adrianoncioiu/Brat-robotic-pentru-desen-caricatural-Licenta-2023/CAD/Pen/Screenshot (135).png

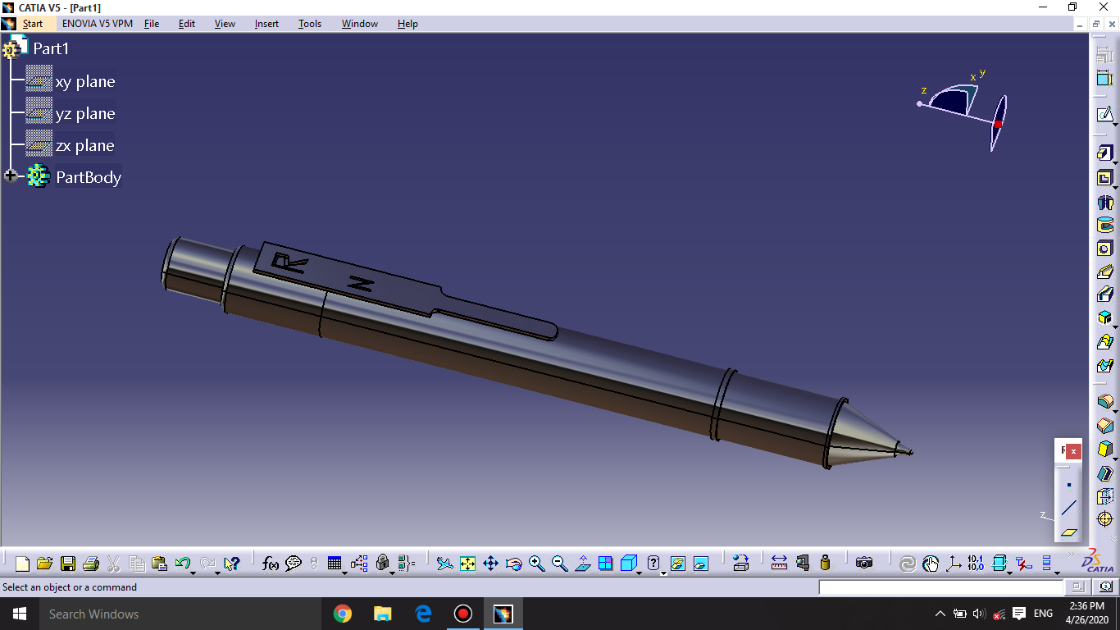
CAD/Pen/Screenshot (135).png
