adrianoncioiu/Brat-robotic-pentru-desen-caricatural-Licenta-2023/img/nou/blabla4.jpeg

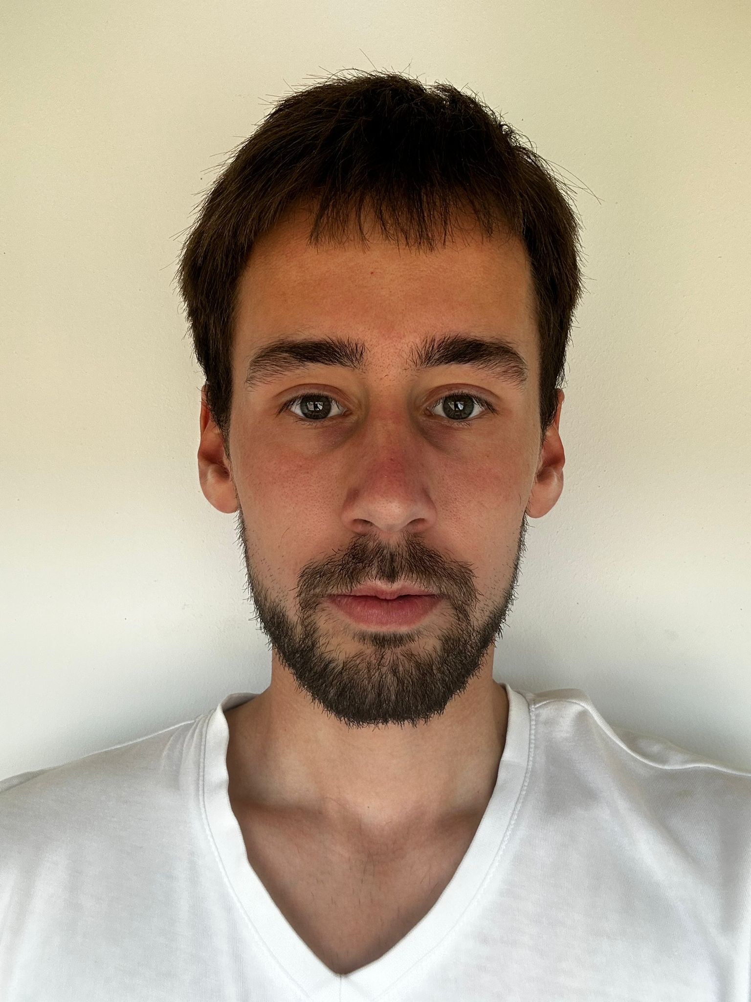
img/nou/blabla4.jpeg
