adrianoncioiu/Brat-robotic-pentru-desen-caricatural-Licenta-2023/img/nou/poza_blur.jpg

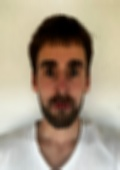
img/nou/poza_blur.jpg
