adrianoncioiu/Brat-robotic-pentru-desen-caricatural-Licenta-2023/img/nou/WhatsApp Image 2023-06-06 at 15.45.43.jpeg

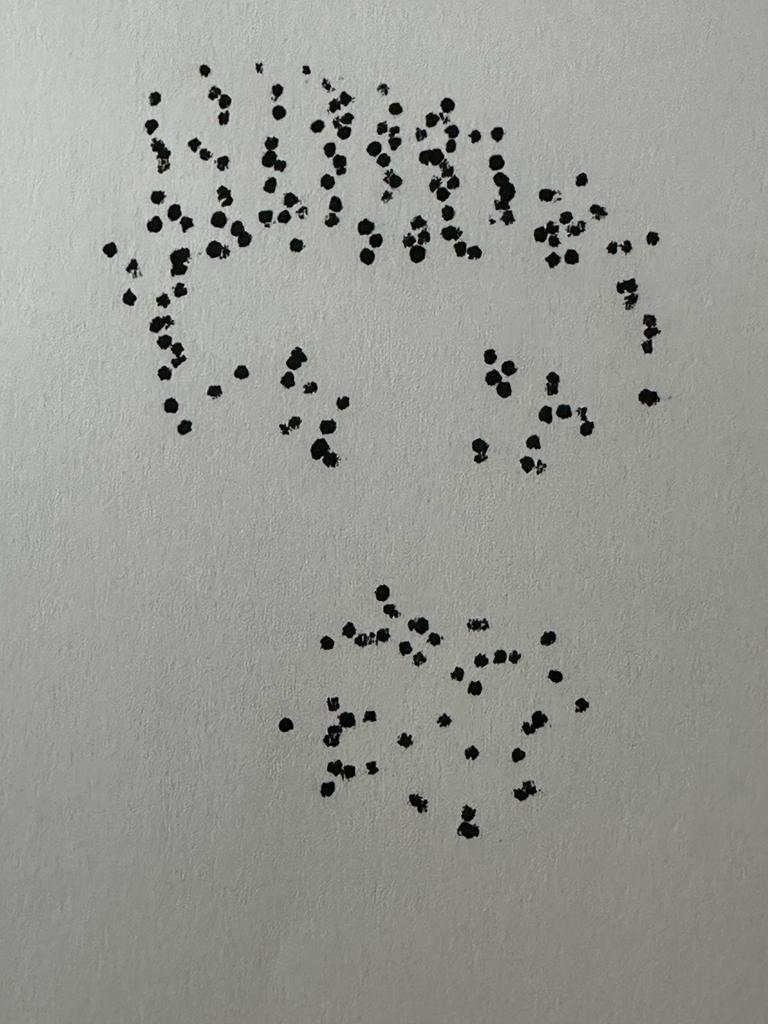
img/nou/WhatsApp Image 2023-06-06 at 15.45.43.jpeg
