adrianoncioiu/Brat-robotic-pentru-desen-caricatural-Licenta-2023/img/raspberry-pi-4-modell-b-4gb-sdram.jpg

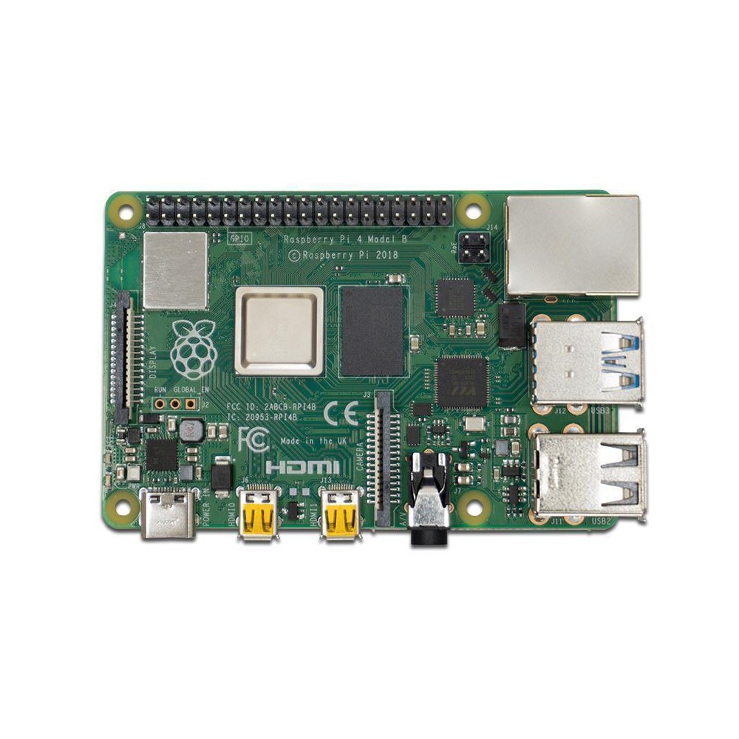
img/raspberry-pi-4-modell-b-4gb-sdram.jpg
