adrianoncioiu/Brat-robotic-pentru-desen-caricatural-Licenta-2023/img/raspberrypi_arduino_uno_serial_usb.png

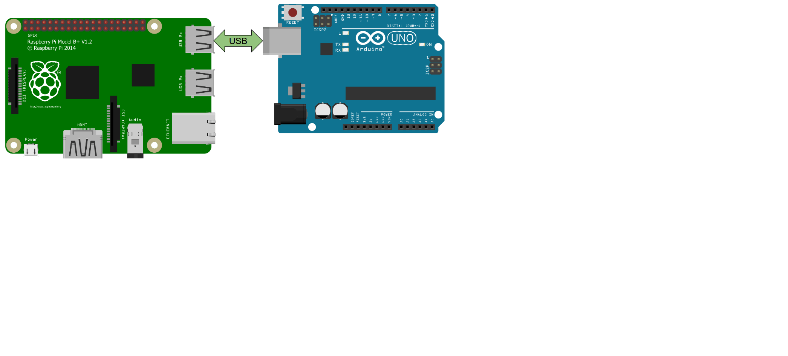
img/raspberrypi_arduino_uno_serial_usb.png
