adrianoncioiu/Brat-robotic-pentru-desen-caricatural-Licenta-2023/img/unnamed.jpg

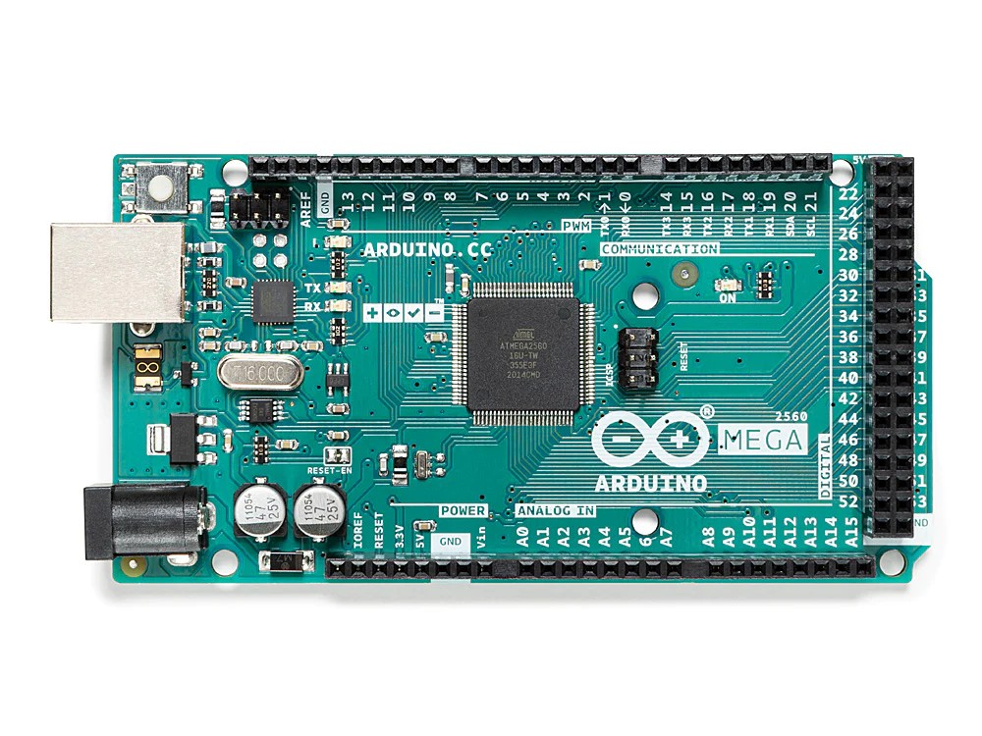
img/unnamed.jpg
