adrianoncioiu/Brat-robotic-pentru-desen-caricatural-Licenta-2023/img/WhatsApp Image 2023-06-01 at 18.26.57.jpeg

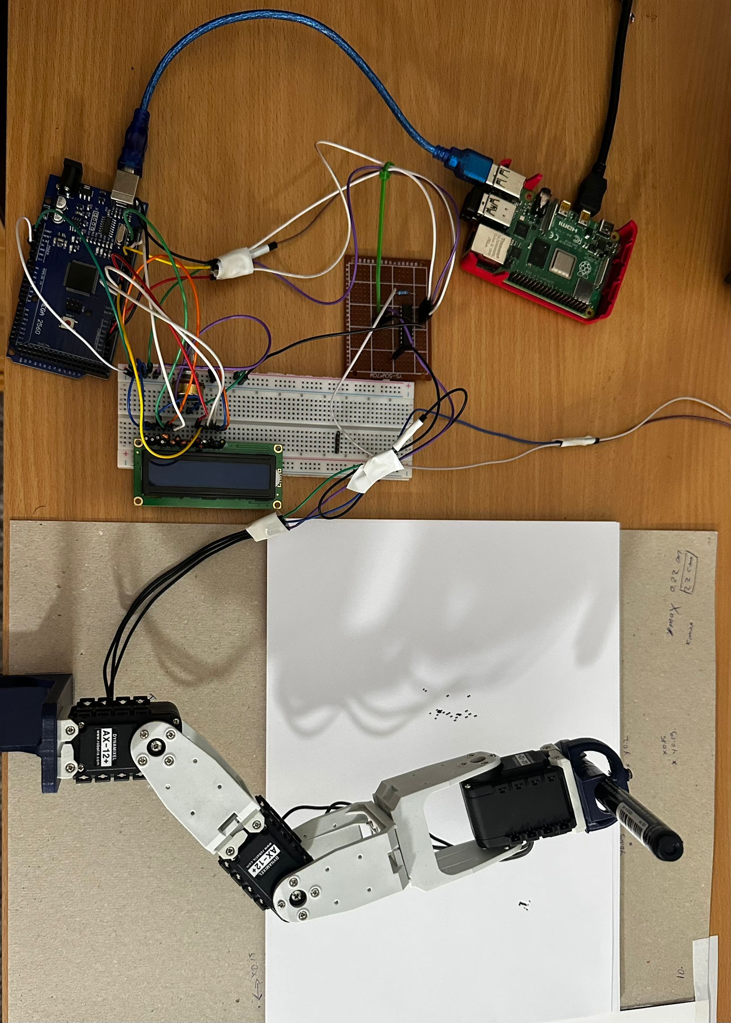
img/WhatsApp Image 2023-06-01 at 18.26.57.jpeg
