adrianoncioiu/Brat-robotic-pentru-desen-caricatural-Licenta-2023/procesare de img/blabla2.jpeg

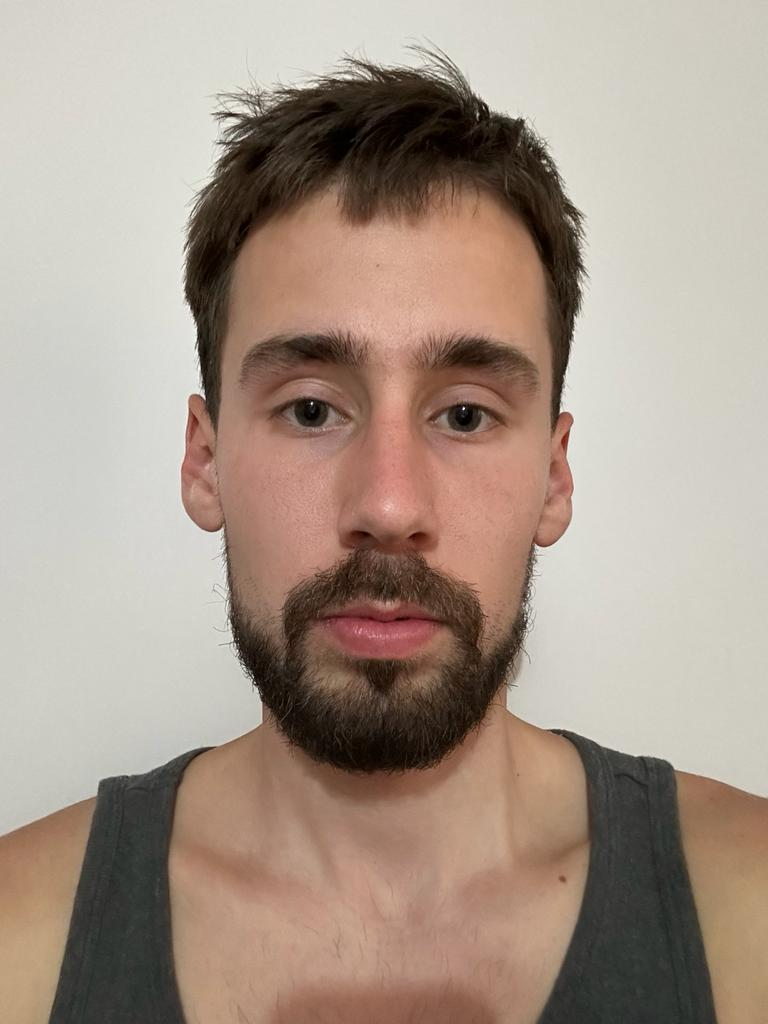
procesare de img/blabla2.jpeg
