adrianoncioiu/Brat-robotic-pentru-desen-caricatural-Licenta-2023/procesare de img/blabla3.jpeg

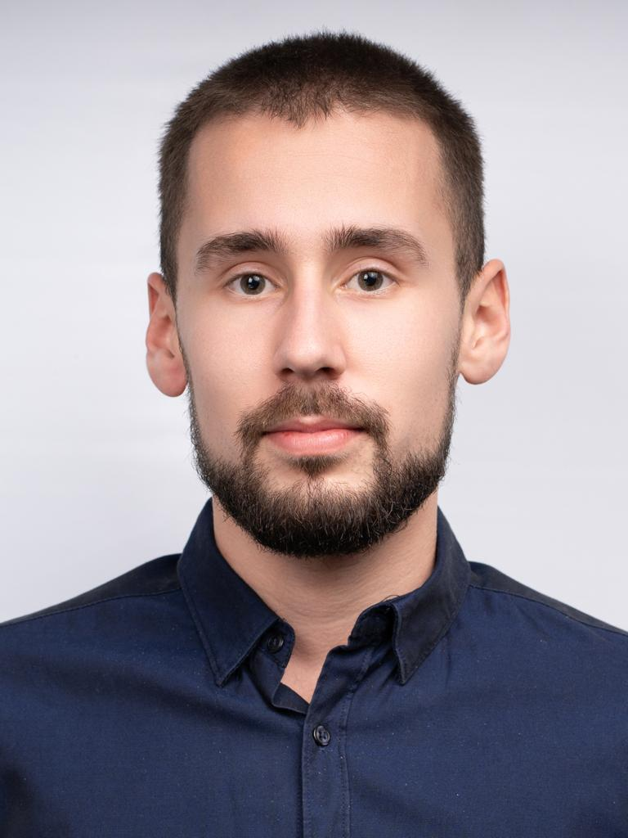
procesare de img/blabla3.jpeg
