adrianoncioiu/Brat-robotic-pentru-desen-caricatural-Licenta-2023/procesare de img/blabla.jpg

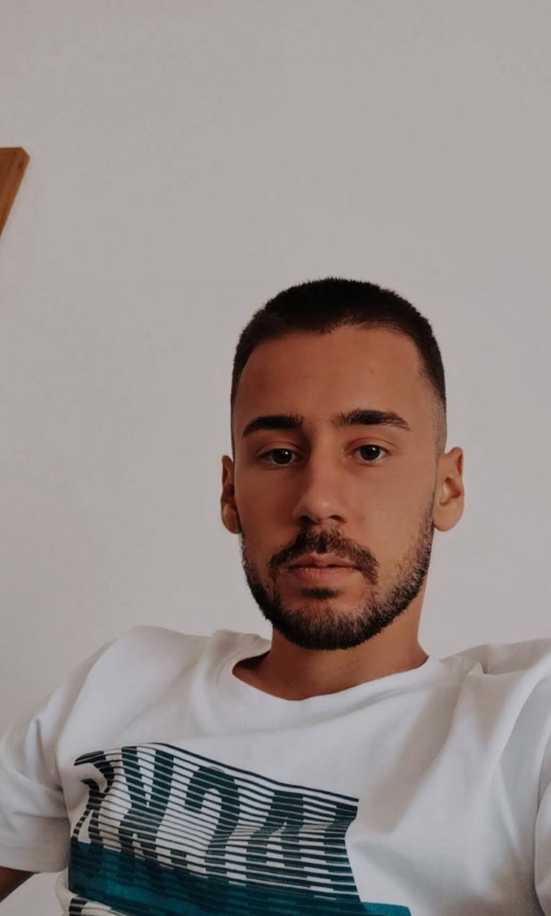
procesare de img/blabla.jpg
