adrianoncioiu/Brat-robotic-pentru-desen-caricatural-Licenta-2023/procesare de img/poza_dilatata.jpg

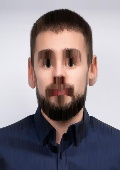
procesare de img/poza_dilatata.jpg
