adrianoncioiu/Brat-robotic-pentru-desen-caricatural-Licenta-2023/CAD/FP04-F4.igs

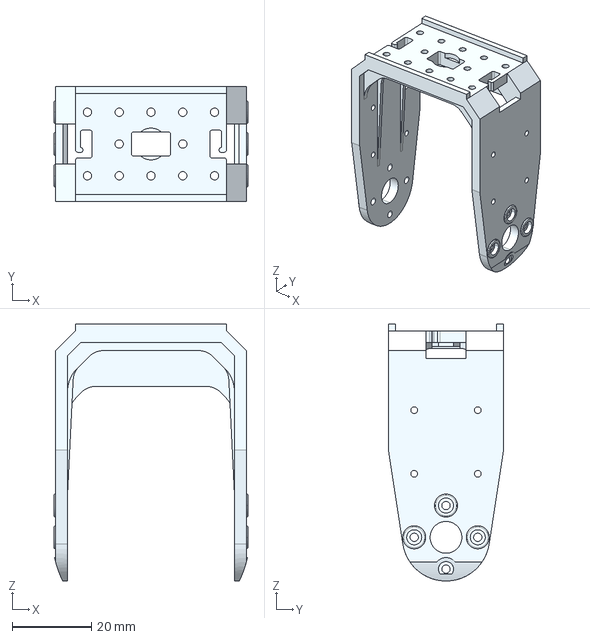
[picture p64: CAD file, 2023-04-28]
CAD/FP04-F4.igs
48.8 x 29.0 x 64.7 mm
