adrianoncioiu/Brat-robotic-pentru-desen-caricatural-Licenta-2023/de printat/Moneda.stl

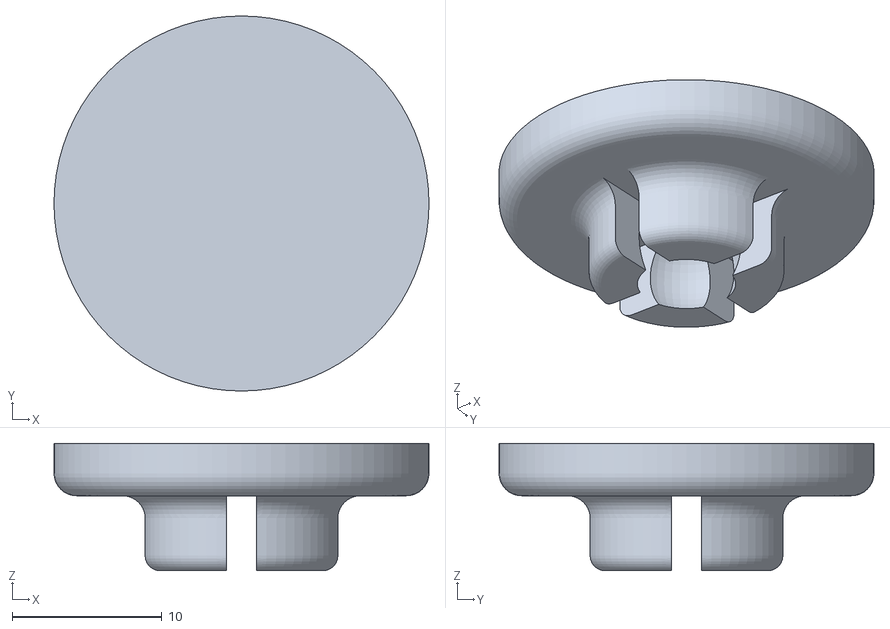
[picture p65: CAD file, 2023-03-07]
de printat/Moneda.stl
25.0 x 25.0 x 8.50
