adrianoncioiu/Brat-robotic-pentru-desen-caricatural-Licenta-2023/dynamixel-ax-12a.snapshot.2/AX-12A.stl

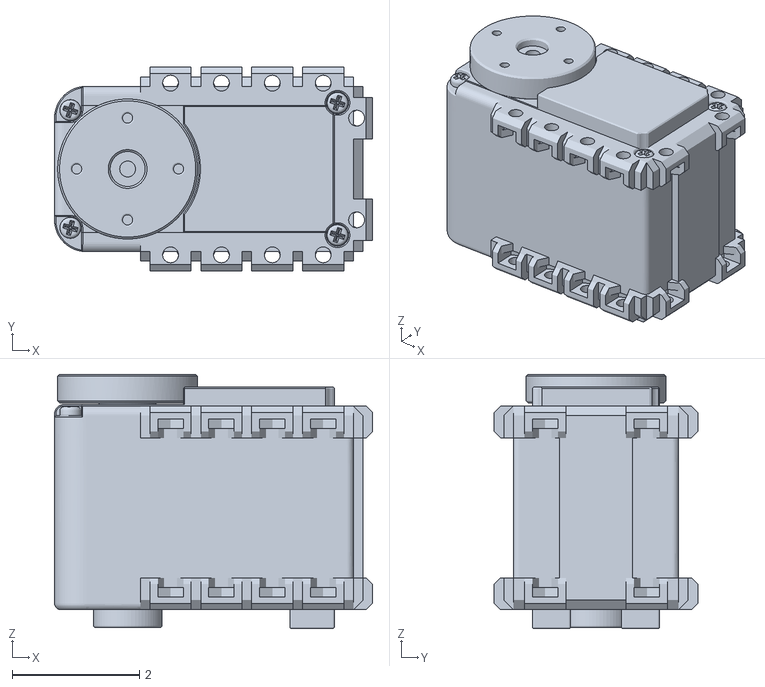
[picture p66: CAD file, 2023-03-07]
dynamixel-ax-12a.snapshot.2/AX-12A.stl
5.00 x 3.20 x 4.00
