adrianoncioiu/Brat-robotic-pentru-desen-caricatural-Licenta-2023/CAD/BPF-BU.stp

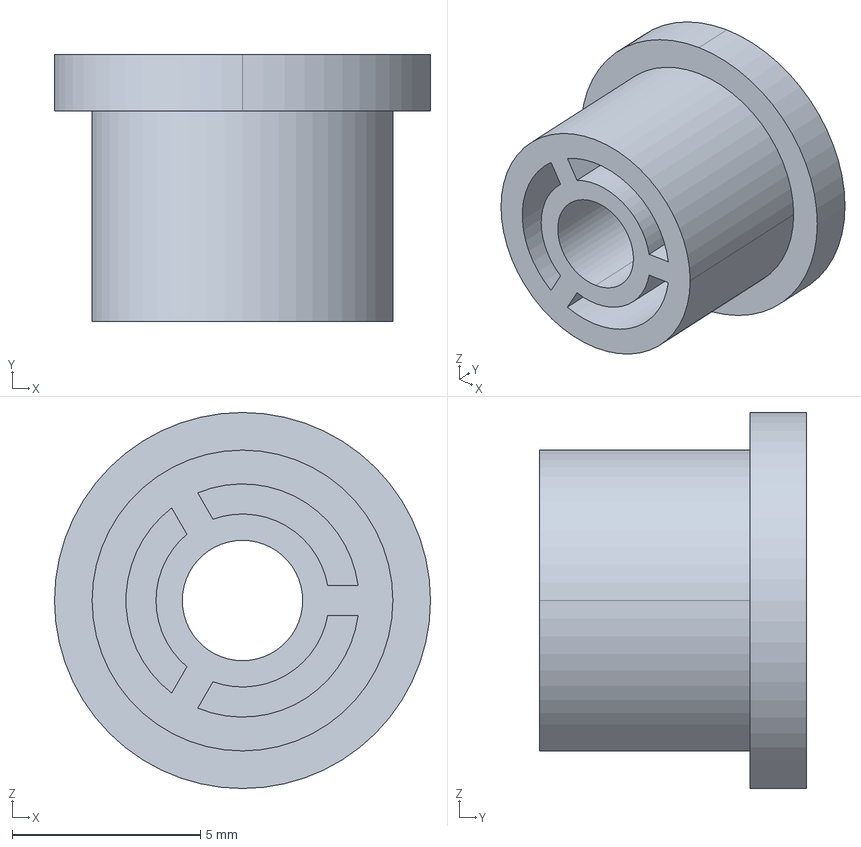
[picture p67: CAD file, 2023-04-28]
CAD/BPF-BU.stp
10.0 x 7.10 x 10.0 mm
