adrianoncioiu/Brat-robotic-pentru-desen-caricatural-Licenta-2023/de printat/Meghina.stl

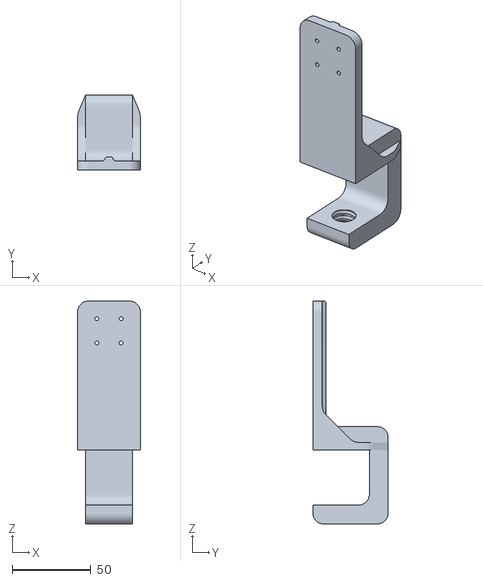
[picture p68: CAD file, 2023-03-07]
de printat/Meghina.stl
40.0 x 48.0 x 142.0
