adrianoncioiu/Brat-robotic-pentru-desen-caricatural-Licenta-2023/CAD/AX-12A.stp

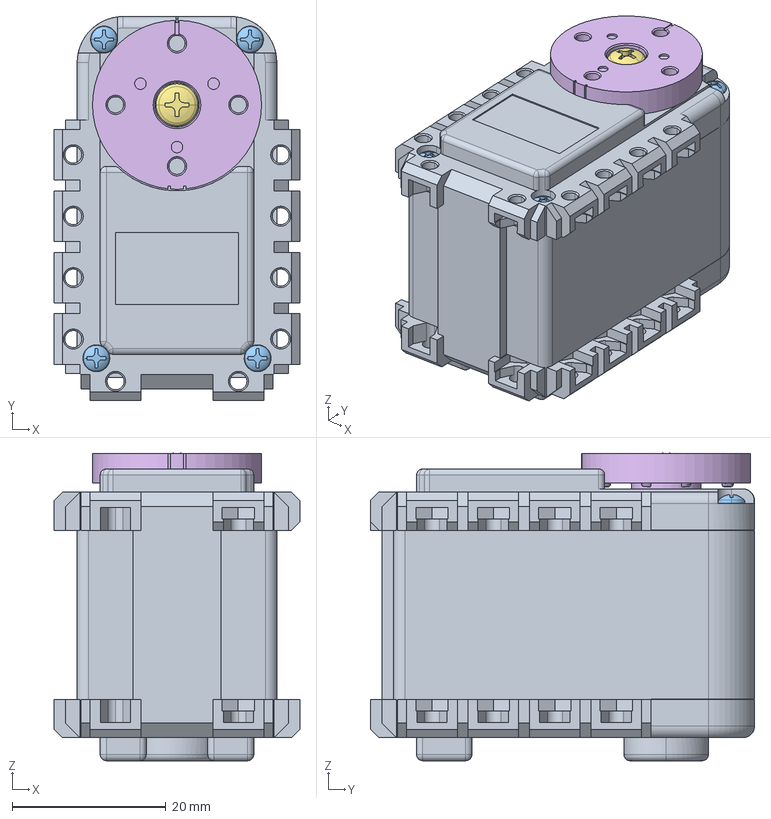
[picture p69: CAD file, 2023-03-07]
CAD/AX-12A.stp
32.0 x 50.0 x 40.0 mm
PRT0001
PRT0002
PRT0003 x 4
PRT0004 x 2
PRT0005
PRT0006
PRT0007
