adrianoncioiu/Brat-robotic-pentru-desen-caricatural-Licenta-2023/CAD/FP04-F2.stp

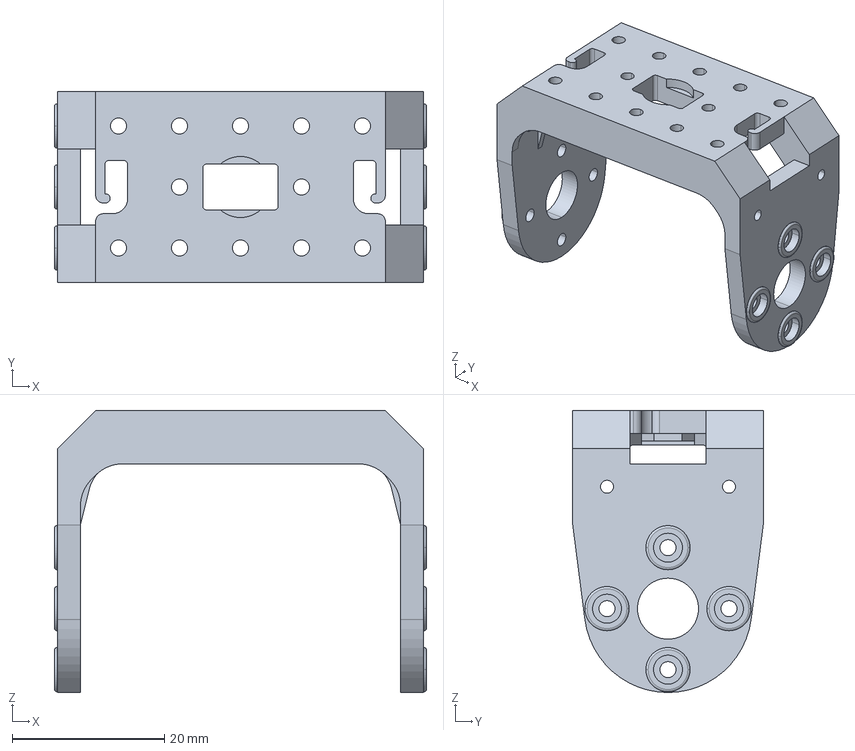
[picture p70: CAD file, 2023-03-07]
CAD/FP04-F2.stp
48.8 x 25.0 x 37.0 mm
