adrianoncioiu/Brat-robotic-pentru-desen-caricatural-Licenta-2023/CAD/FP04-F3.stp

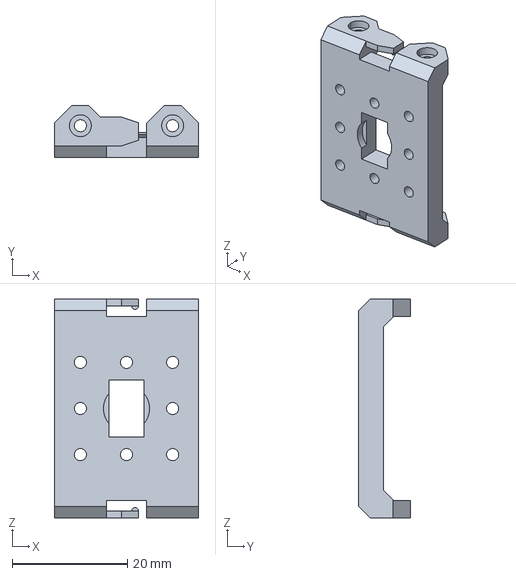
[picture p71: CAD file, 2023-03-07]
CAD/FP04-F3.stp
25.0 x 9.00 x 38.0 mm
