adrianoncioiu/Brat-robotic-pentru-desen-caricatural-Licenta-2023/(list of files, cad)

Other CAD files:
CAD/FP04-F4 (1).stp
CAD/0.0.CATPart
CAD/10179925.CATPart
CAD/10325612.CATPart
CAD/ASM0001_ASM.1.9.CATProduct
CAD/ASM0001_ASM.1.CATProduct
CAD/AX-12A.CATProduct
CAD/BPF-BU.CATPart
CAD/BPF-BU.dwg
CAD/BPF-BU.igs
CAD/FP04-F2.CATPart
CAD/FP04-F3.CATPart
CAD/FP04-F4.CATPart
CAD/FP04-F4.dwg
CAD/Masa.CATPart
CAD/PRT0001.5.13.CATPart
CAD/PRT0001.5.CATPart
CAD/PRT0001.CATPart
CAD/PRT0002.6.14.CATPart
CAD/PRT0002.6.CATPart
CAD/PRT0002.CATPart
CAD/PRT0003.7.15.CATPart
CAD/PRT0003.7.CATPart
CAD/PRT0003.CATPart
CAD/PRT0004.8.16.CATPart
CAD/PRT0004.8.CATPart
CAD/PRT0004.CATPart
CAD/PRT0005.2.10.CATPart
CAD/PRT0005.2.CATPart
CAD/PRT0005.CATPart
CAD/PRT0006.3.11.CATPart
CAD/PRT0006.3.CATPart
CAD/PRT0006.CATPart
CAD/PRT0007.4.12.CATPart
CAD/PRT0007.4.CATPart
CAD/PRT0007.CATPart
CAD/Pen/Pen.CATPart
CAD/ROBOT_3d.CATProduct
CAD/foaie.CATPart
