adrianoncioiu/Brat-robotic-pentru-desen-caricatural-Licenta-2023/CAD/BPF-BU.pdf

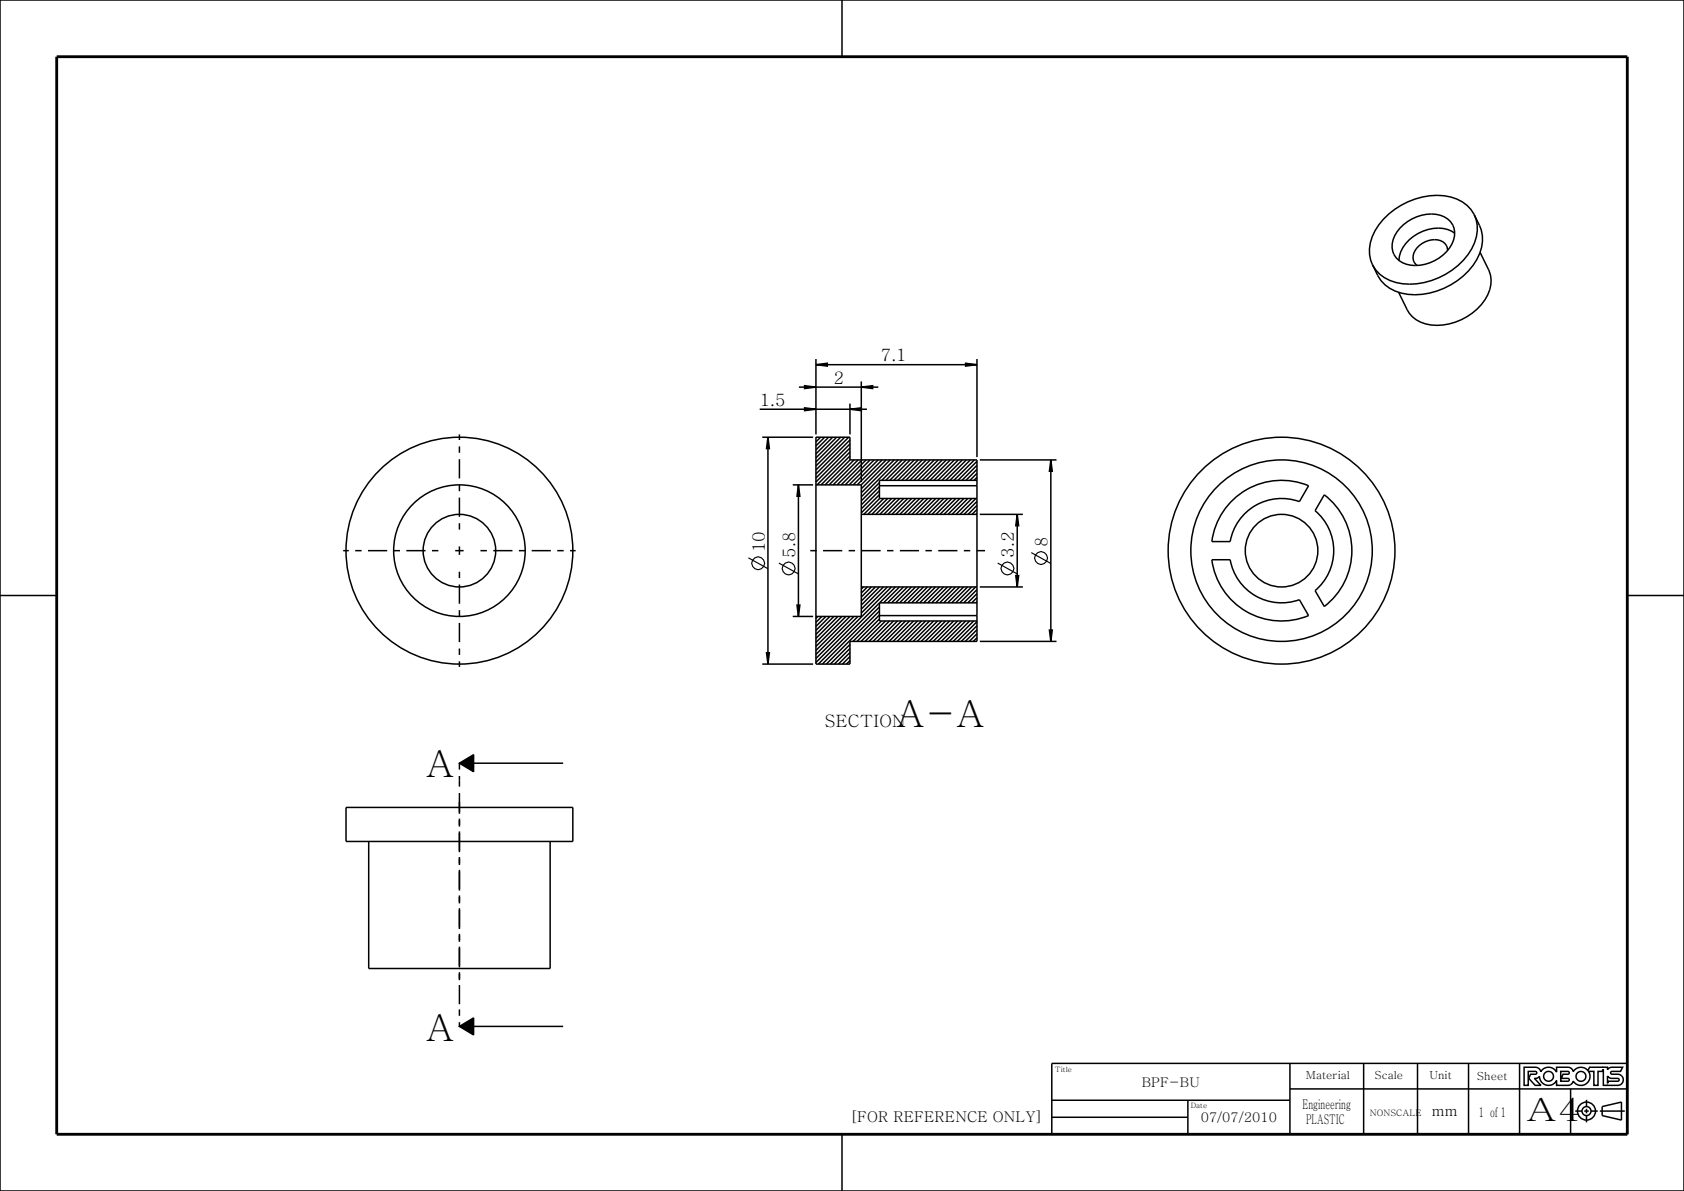
[picture p72: page 1]
NONSCALE; SECTION A-A

Title BPF-BU | Material | Scale | Unit | Sheet

[FOR REFERENCE ONLY]

PLASTIC | | mm | 1 of 1 Engineering
Date 07/07/2010
