adrianoncioiu/Brat-robotic-pentru-desen-caricatural-Licenta-2023/scheme circuit/schema2_bb.pdf

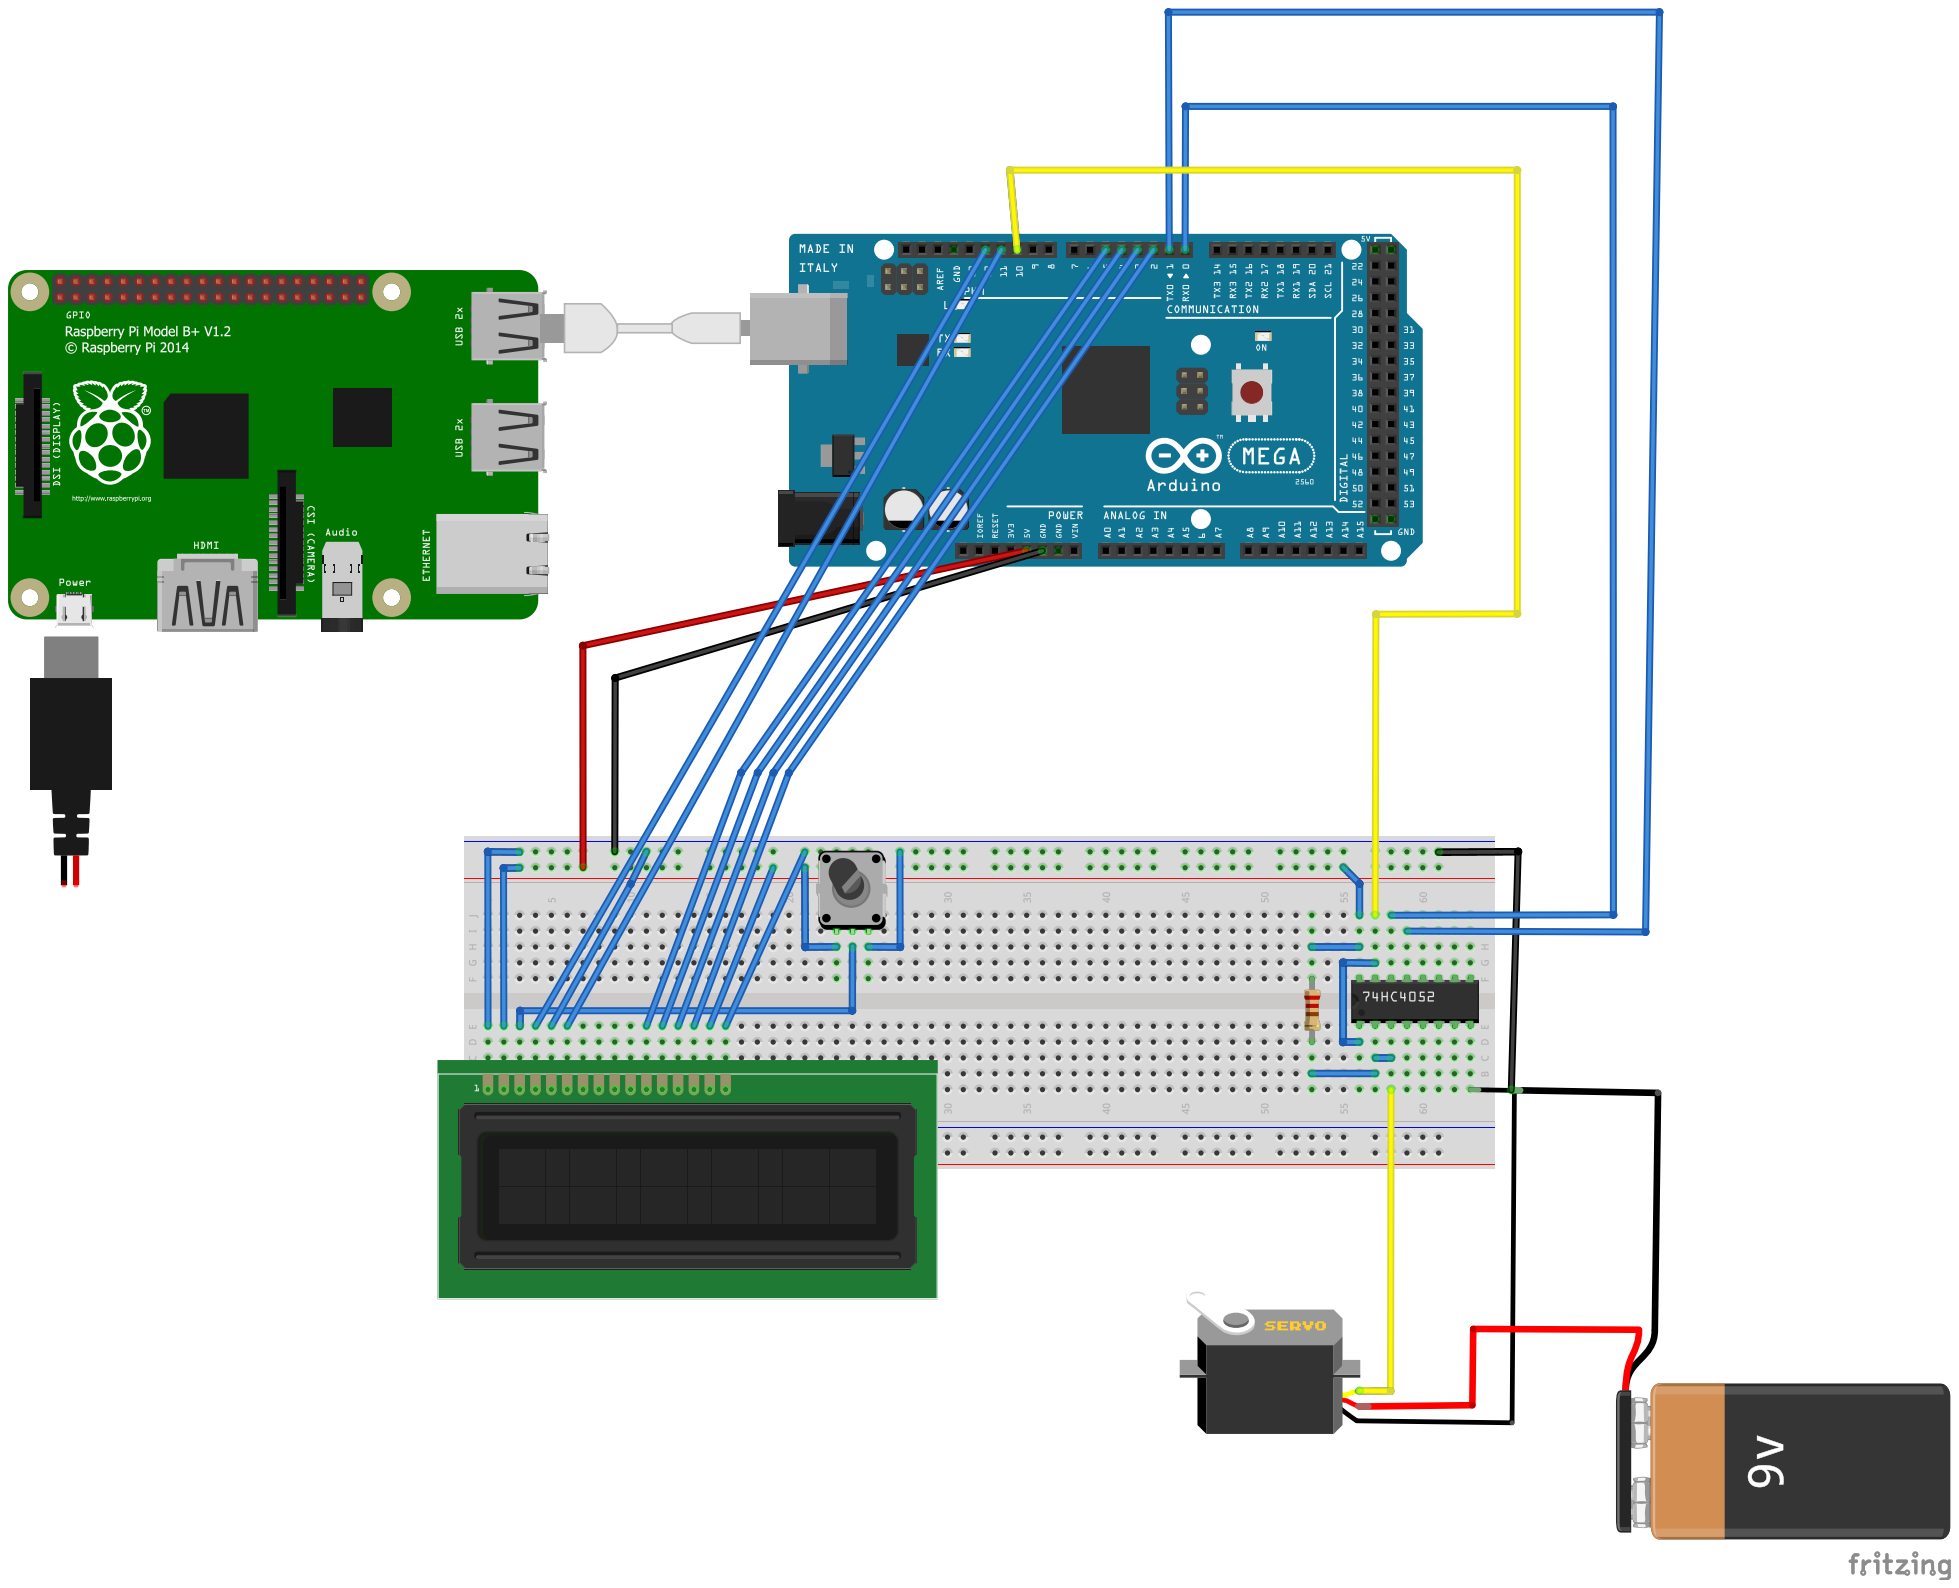
[picture p73: page 1]
