adrianoncioiu/Brat-robotic-pentru-desen-caricatural-Licenta-2023/scheme circuit/schema2_schem.pdf

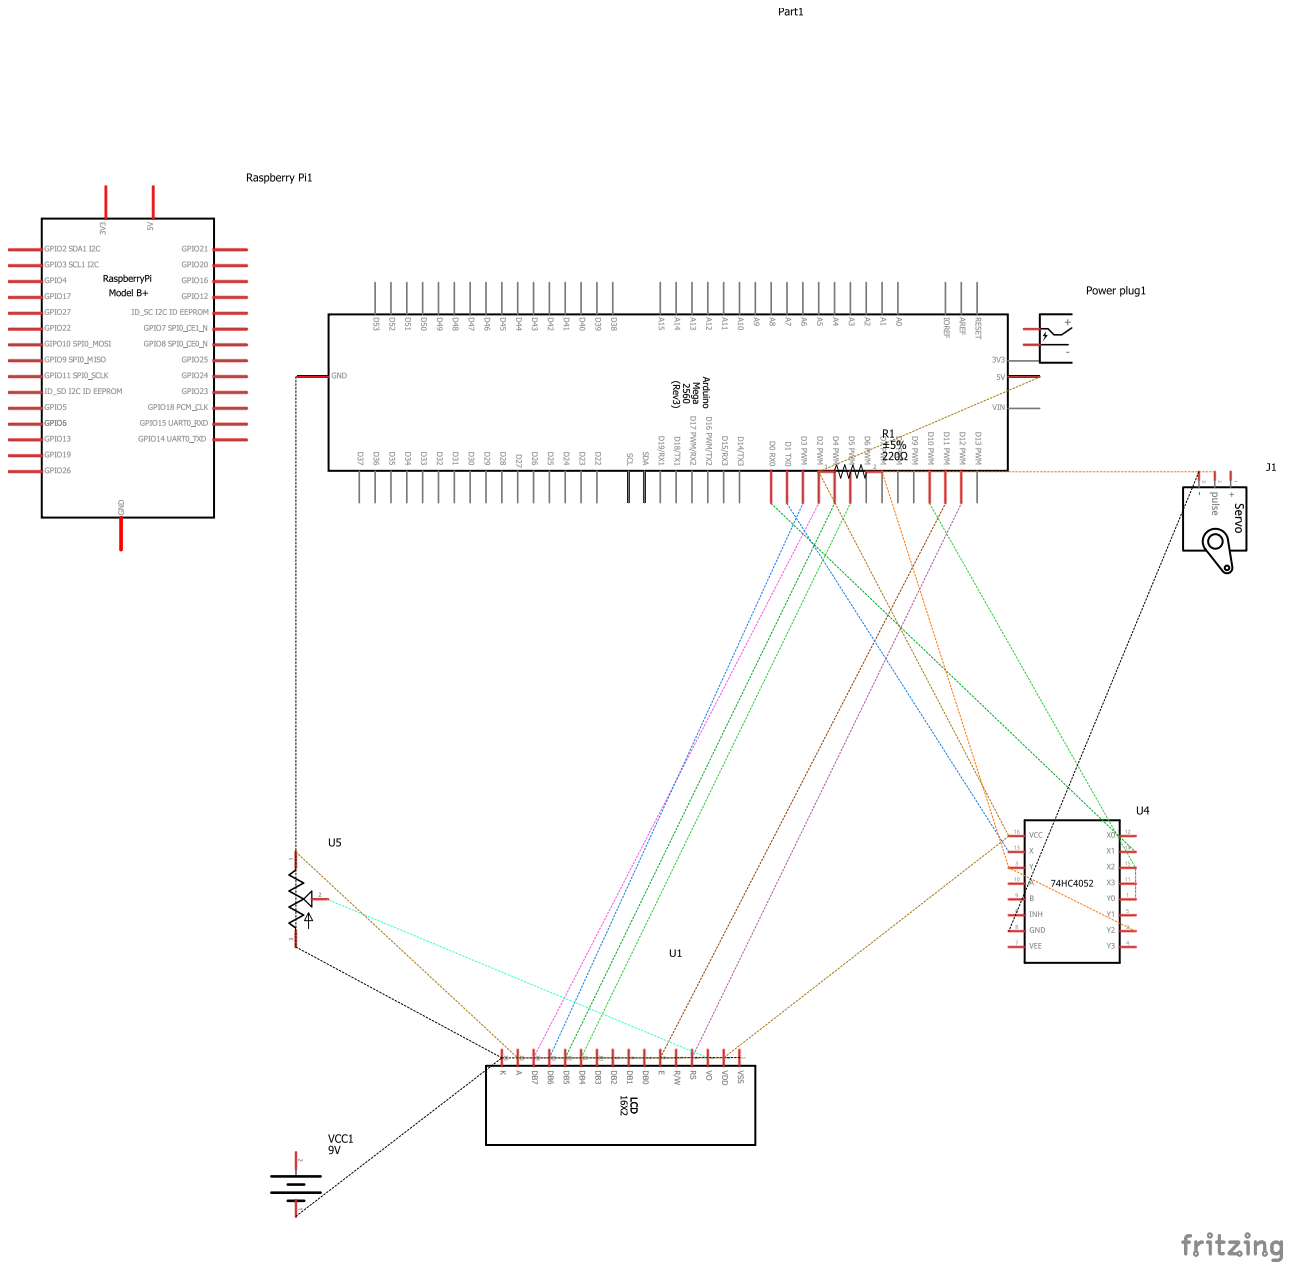
[picture p74: page 1]
