adrianoncioiu/Brat-robotic-pentru-desen-caricatural-Licenta-2023/scheme circuit/schema3_bb.pdf

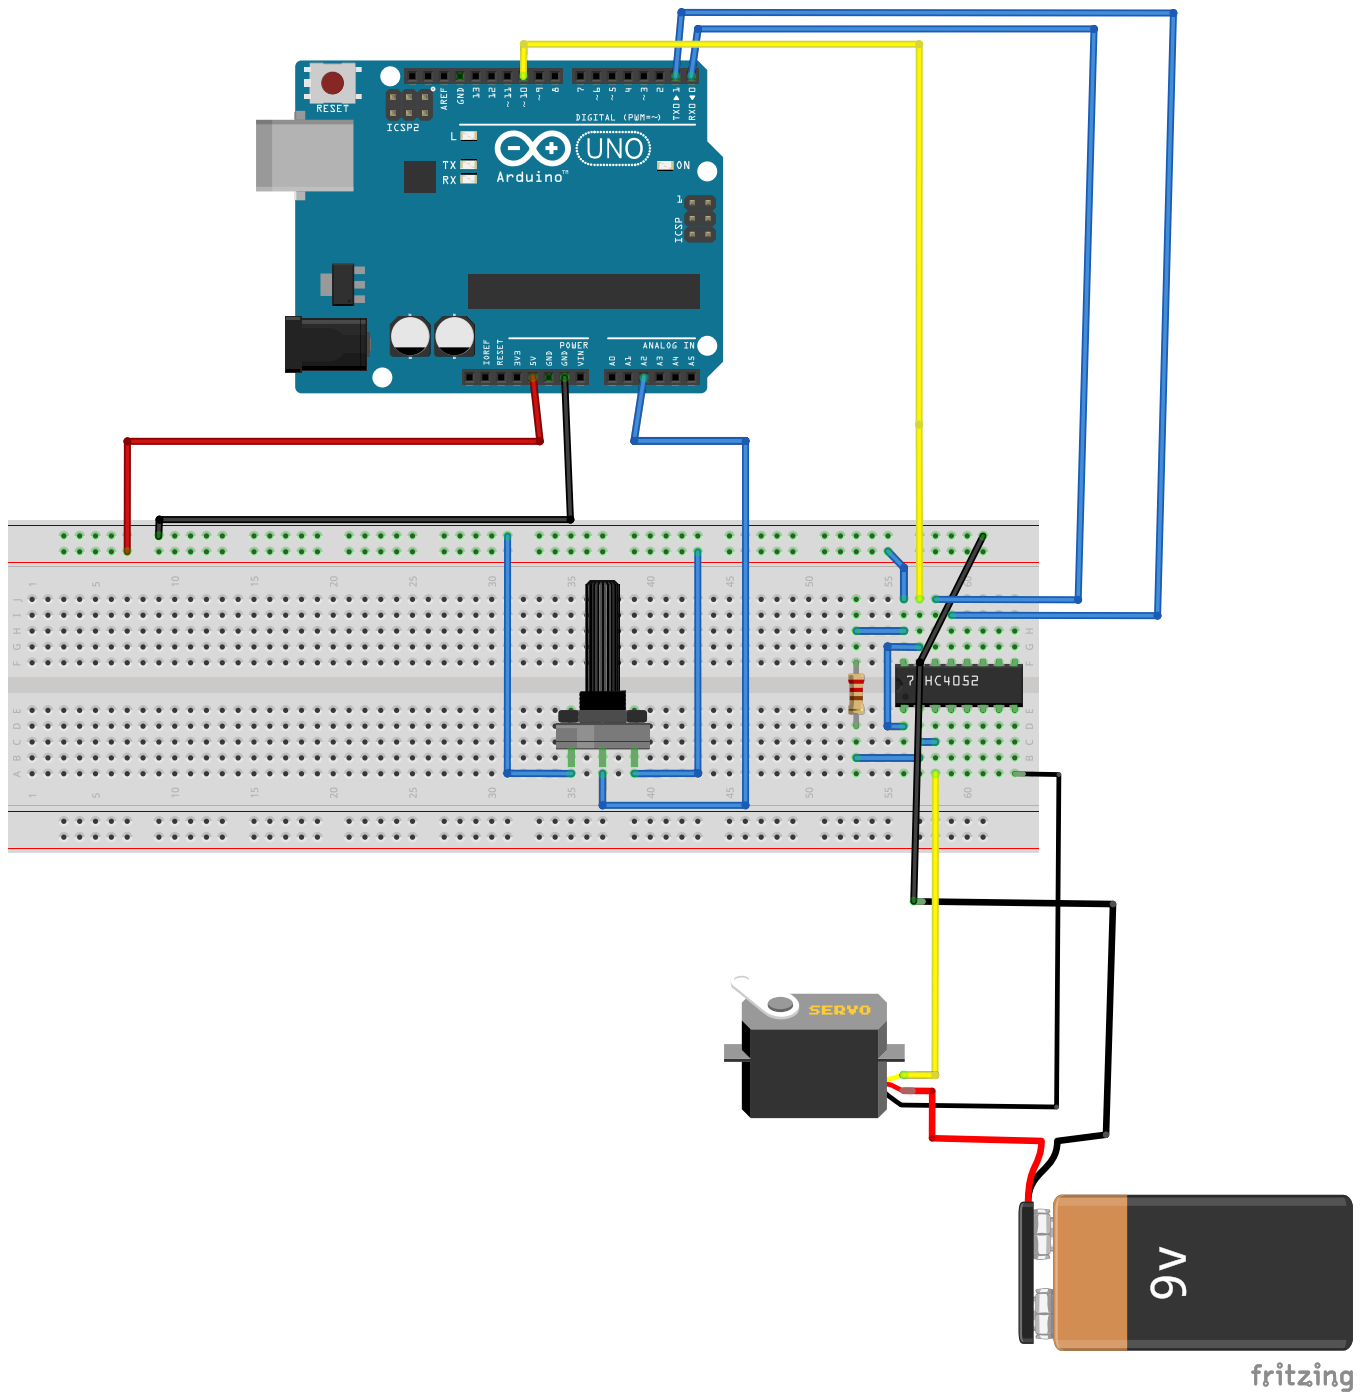
[picture p75: page 1]
