adrianoncioiu/Brat-robotic-pentru-desen-caricatural-Licenta-2023/scheme circuit/schema3_schem.pdf

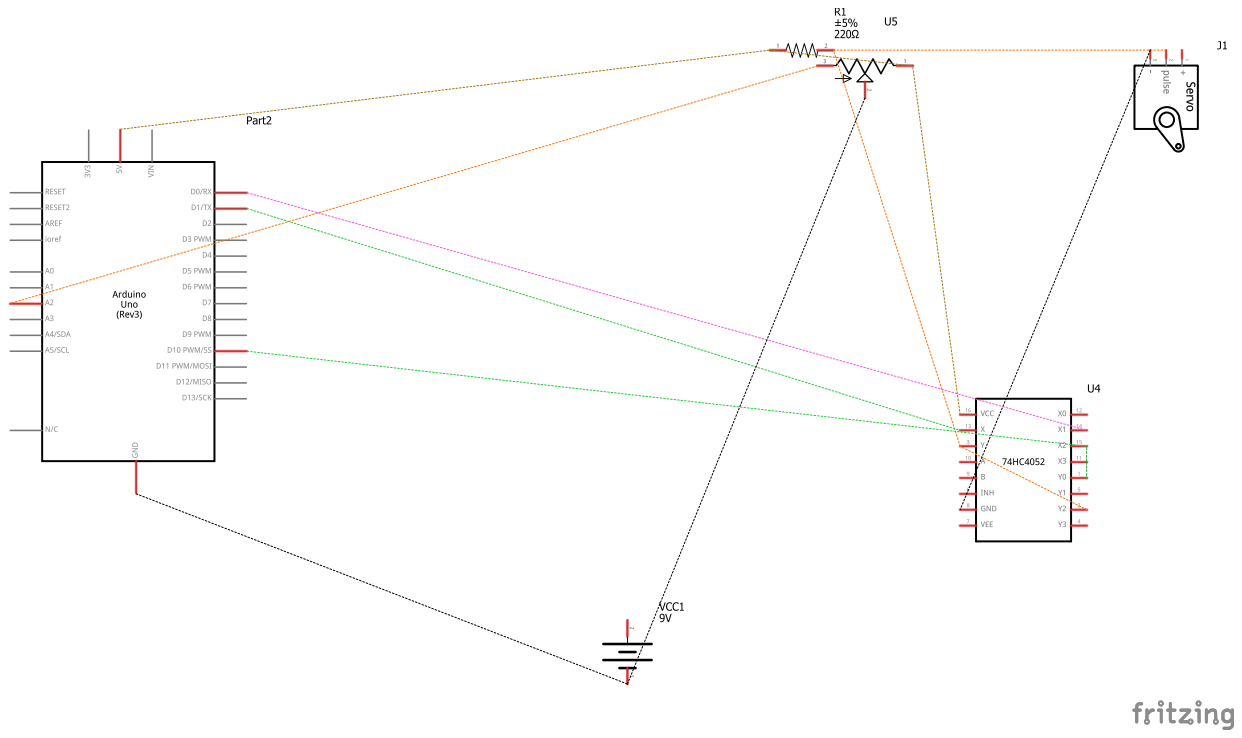
[picture p76: page 1]
