adrianoncioiu/Brat-robotic-pentru-desen-caricatural-Licenta-2023/CAD/FP04-F4.pdf

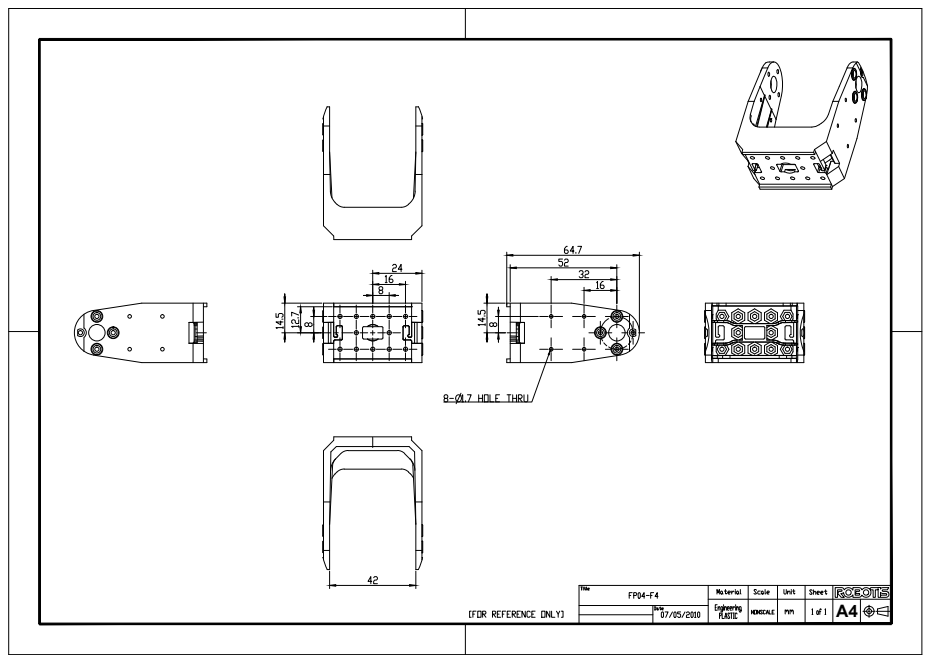
[picture p77: page 1]
