adrianoncioiu/Brat-robotic-pentru-desen-caricatural-Licenta-2023/(list of files, drawings)

Other design files:
img/fritzing.0.9.3b/fritzing.0.9.3b.32.pc/sketches/core/7Segment_direct.fzz
img/fritzing.0.9.3b/fritzing.0.9.3b.32.pc/sketches/core/555TouchSwitch.fzz
img/fritzing.0.9.3b/fritzing.0.9.3b.32.pc/sketches/core/Amplification.fzz
img/fritzing.0.9.3b/fritzing.0.9.3b.32.pc/sketches/core/AnalogInputFSR.fzz
img/fritzing.0.9.3b/fritzing.0.9.3b.32.pc/sketches/core/AnalogInputOutput.fzz
img/fritzing.0.9.3b/fritzing.0.9.3b.32.pc/sketches/core/AnalogInputPot.fzz
img/fritzing.0.9.3b/fritzing.0.9.3b.32.pc/sketches/core/AnalogInputThermistor.fzz
img/fritzing.0.9.3b/fritzing.0.9.3b.32.pc/sketches/core/AnalogInputToServo.fzz
img/fritzing.0.9.3b/fritzing.0.9.3b.32.pc/sketches/core/Arduino-no-FTDI.fzz
img/fritzing.0.9.3b/fritzing.0.9.3b.32.pc/sketches/core/ArduinoISP.fzz
img/fritzing.0.9.3b/fritzing.0.9.3b.32.pc/sketches/core/Barebones Arduino (stripboard).fzz
img/fritzing.0.9.3b/fritzing.0.9.3b.32.pc/sketches/core/Button.fzz
img/fritzing.0.9.3b/fritzing.0.9.3b.32.pc/sketches/core/color-fader.fzz
img/fritzing.0.9.3b/fritzing.0.9.3b.32.pc/sketches/core/CosmicRayGun.fzz
img/fritzing.0.9.3b/fritzing.0.9.3b.32.pc/sketches/core/Countdown.fzz
img/fritzing.0.9.3b/fritzing.0.9.3b.32.pc/sketches/core/DC_motor_control.fzz
img/fritzing.0.9.3b/fritzing.0.9.3b.32.pc/sketches/core/Fritzing Creator Kit DE+EN/creator-kit-de/Fritzing/Blink.fzz
img/fritzing.0.9.3b/fritzing.0.9.3b.32.pc/sketches/core/Fritzing Creator Kit DE+EN/creator-kit-de/Fritzing/Fading.fzz
img/fritzing.0.9.3b/fritzing.0.9.3b.32.pc/sketches/core/Fritzing Creator Kit DE+EN/creator-kit-de/Fritzing/FlipFlop.fzz
img/fritzing.0.9.3b/fritzing.0.9.3b.32.pc/sketches/core/Fritzing Creator Kit DE+EN/creator-kit-de/Fritzing/H-Bridge.fzz
img/fritzing.0.9.3b/fritzing.0.9.3b.32.pc/sketches/core/Fritzing Creator Kit DE+EN/creator-kit-de/Fritzing/Lauflicht.fzz
img/fritzing.0.9.3b/fritzing.0.9.3b.32.pc/sketches/core/Fritzing Creator Kit DE+EN/creator-kit-de/Fritzing/Lichtautomatik.fzz
img/fritzing.0.9.3b/fritzing.0.9.3b.32.pc/sketches/core/Fritzing Creator Kit DE+EN/creator-kit-de/Fritzing/Matrix.fzz
img/fritzing.0.9.3b/fritzing.0.9.3b.32.pc/sketches/core/Fritzing Creator Kit DE+EN/creator-kit-de/Fritzing/Nachtlicht.fzz
img/fritzing.0.9.3b/fritzing.0.9.3b.32.pc/sketches/core/Fritzing Creator Kit DE+EN/creator-kit-de/Fritzing/PingPong.fzz
img/fritzing.0.9.3b/fritzing.0.9.3b.32.pc/sketches/core/Fritzing Creator Kit DE+EN/creator-kit-de/Fritzing/Potentiometer.fzz
img/fritzing.0.9.3b/fritzing.0.9.3b.32.pc/sketches/core/Fritzing Creator Kit DE+EN/creator-kit-de/Fritzing/ProcessingRGB.fzz
img/fritzing.0.9.3b/fritzing.0.9.3b.32.pc/sketches/core/Fritzing Creator Kit DE+EN/creator-kit-de/Fritzing/Servo.fzz
img/fritzing.0.9.3b/fritzing.0.9.3b.32.pc/sketches/core/Fritzing Creator Kit DE+EN/creator-kit-de/Fritzing/Synthesizer.fzz
img/fritzing.0.9.3b/fritzing.0.9.3b.32.pc/sketches/core/Fritzing Creator Kit DE+EN/creator-kit-de/Fritzing/TwitterSaurus.fzz
img/fritzing.0.9.3b/fritzing.0.9.3b.32.pc/sketches/core/Fritzing Creator Kit DE+EN/creator-kit-de/Fritzing/Verstaerkung.fzz
img/fritzing.0.9.3b/fritzing.0.9.3b.32.pc/sketches/core/Fritzing Creator Kit DE+EN/creator-kit-de/Fritzing/Wahrsager.fzz
img/fritzing.0.9.3b/fritzing.0.9.3b.32.pc/sketches/core/Fritzing Creator Kit DE+EN/creator-kit-de/Fritzing/Zaubertafel.fzz
img/fritzing.0.9.3b/fritzing.0.9.3b.32.pc/sketches/core/Fritzing Creator Kit DE+EN/creator-kit-en/Fritzing/Amplification.fzz
img/fritzing.0.9.3b/fritzing.0.9.3b.32.pc/sketches/core/Fritzing Creator Kit DE+EN/creator-kit-en/Fritzing/AutomaticLightingSystem.fzz
img/fritzing.0.9.3b/fritzing.0.9.3b.32.pc/sketches/core/Fritzing Creator Kit DE+EN/creator-kit-en/Fritzing/Blink.fzz
img/fritzing.0.9.3b/fritzing.0.9.3b.32.pc/sketches/core/Fritzing Creator Kit DE+EN/creator-kit-en/Fritzing/ChaserLights.fzz
img/fritzing.0.9.3b/fritzing.0.9.3b.32.pc/sketches/core/Fritzing Creator Kit DE+EN/creator-kit-en/Fritzing/Fading.fzz
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
